cubitel/car-audio/pcb/audio-bom.ods

RefDes |  | Value | Package | Vendor | Part number
C1,C22,C23,C24,C25,C30,C31,C32,C33 | 9 | 1uF 25V X7R | 0805 | Murata | GRM21BR71E105K
C2,C5,C9,C13,C39,C40,C47,C48,C49,C50,C52,C54,C55,C56,C62,C66,C67,C69,C70,C71,C72,C74,C75,C76,C77,C78,C79 | 27 | 0.1uF | 0603
C3,C7,C11 | 3 | 10uF 25V | 1210
C4,C6,C8,C14,C15,C16,C17,C18,C19,C20,C21 | 11 | 1uF 25V X5R | 0603 | Murata | GRM188R61E105K
C10,C12 | 2 | 2.2uF 25V X7R | 0805 | Murata | GRM21BR71E225K
C26,C27,C28,C29,C34,C35,C36,C37 | 8 | 0.01uF | 0603
D1 | 1 | TAS6424Q | SSOP-56 | TI | TAS6424QDKQQ1
D2 | 1 | STM32F407 | TQFP-100 | ST | STM32F407V6T
D3 | 1 | TPS2042BD | SOIC-8
D4 | 1 | TJA1100 | QFN-36 | NXP
D5,D6 | 2 | TJA1041 | SOIC-14 | NXP
D7 | 1 | TLE8366EV50 | SOIC-8 | INFINEON | TLE8366EV50XUMA1
D8 | 1 | LD1117-33 | SOT-223
L1,L2,L3,L4,L5,L6,L7,L8 | 8 | 3.3uH 10A |  | BOURNS | SRP1038A-3R3M
L9,L12,L13,L14 | 4
L10,L11 | 2 | 120nH
L15,L16,L17 | 3 | 100uH |  | EPCOS | B82789C0104N002
L18 | 1 | 4.7uH 10A |  | BOURNS | SRP1038A-4R7M
L19,L20 | 2 | 47uH |  | EPCOS | B82477G4473M
R1,R2,R3,R4 | 4 | 10 | 0603
R5 | 1 | 220 | 0603
R6,R13,R15 | 3 | 1.5k | 0603
R7 | 1 | 5.1k | 0603
R8,R9,R11,R12 | 4 | 4.7k | 0603
R14,R16,R17,R18,R19,R20 | 6 | 10k | 0603
R21,R22,R23,R24 | 4 | 51 | 0603
R25,R26,R28,R29 | 4 | 1k | 0603
R27 | 1 | 100k | 0603
R30,R31 | 2 | 120 | 0603
R32 | 1 | 22k | 0603
VD1,VD2,VD3 | 3 |  |  | ST | ESDCAN03-2BWY
VD4,VD5 | 2 | 15MQ040 | SMA
X1,X2 |  |  |  |  | PBS-8
X3 | 1 | Quadlock |  | TE | 1241768-1
Z1 | 1 | 8 MHz |  | ABRACON | ABM3B-8.000MHZ-B2-T
Z2 | 1 | 25 MHz |  | ABRACON | ABM3B-25.000MHZ-B2-T
