cubitel/car-audio/case/case.SLDPRT

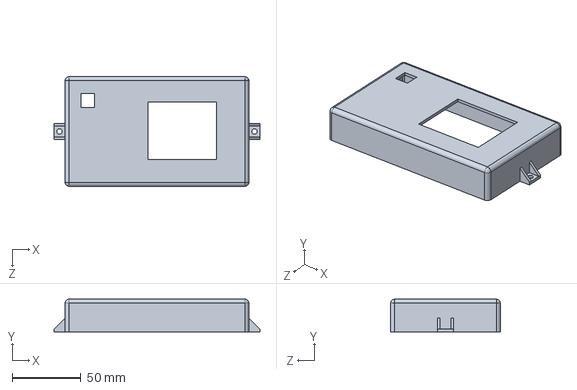
[picture p1: CAD file, 2018-12-22]
case/case.SLDPRT
150.0 x 24.0 x 80.0 mm
