cubitel/car-audio/(list of files, cad)

Other CAD files:
case/case.STL
