cubitel/car-audio/pcb/audio.kicad_pcb

## KiCad design pcb/audio.kicad_pcb (2018-12-22)

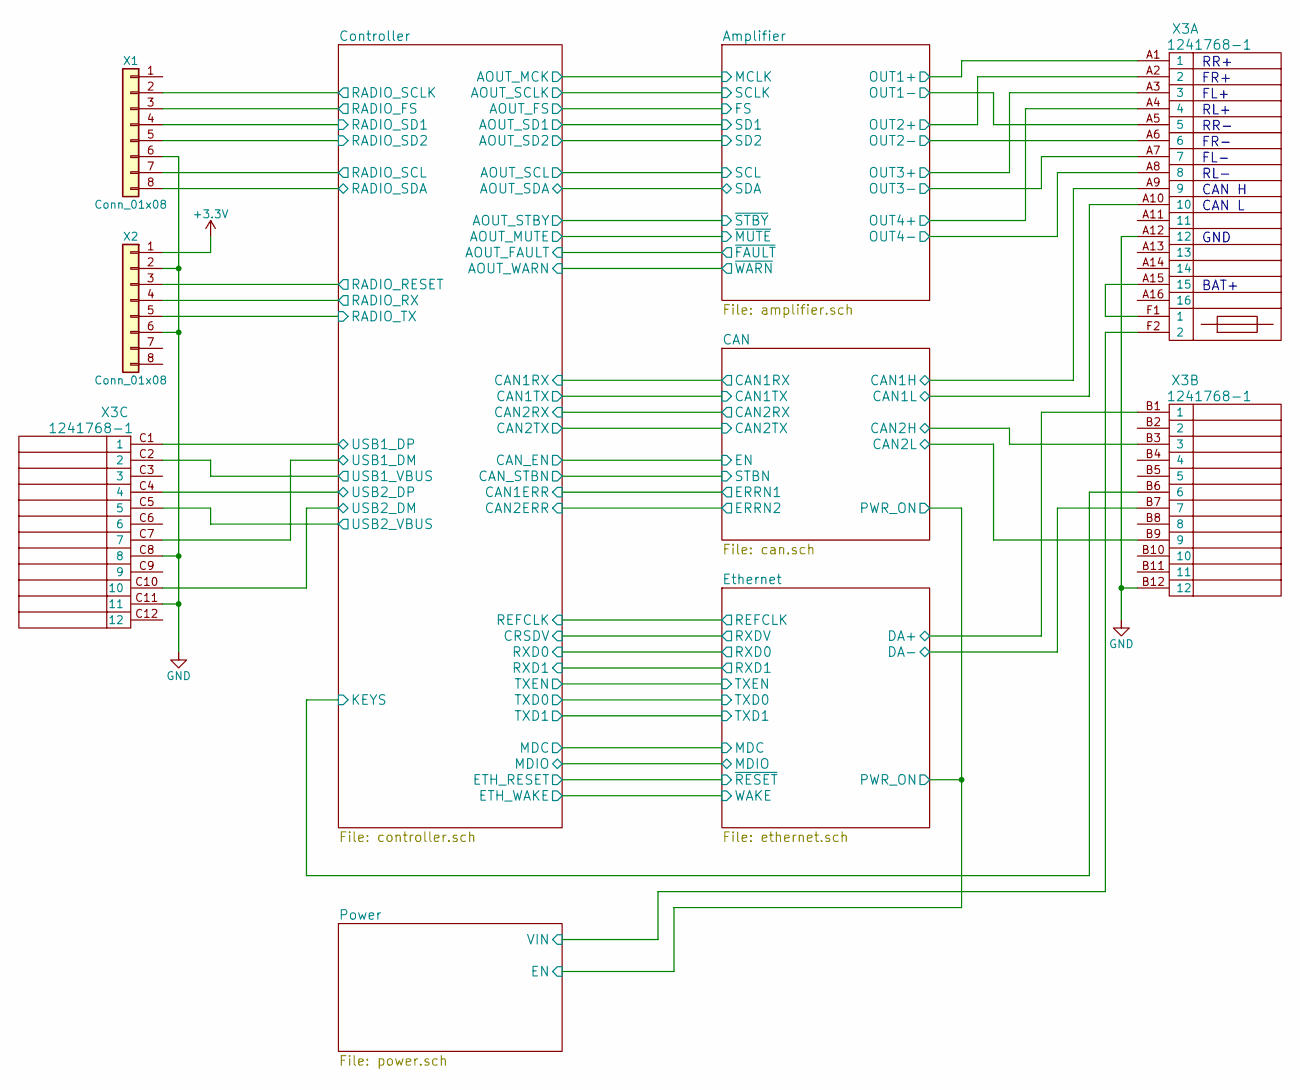
[picture p2: schematic audio.sch]

Parts:
X1, X2: Conn_01x08; Pin_Header_Straight_1x08_Pitch2.54mm
X3: 1241768-1; 1241768

Connections:
+3V3: X2.1; also elsewhere on the board
/Amplifier/OUT1+: X3.A1 (1); also elsewhere on the board
/Amplifier/OUT1-: X3.A5 (5); also elsewhere on the board
/Amplifier/OUT2+: X3.A2 (2); also elsewhere on the board
/Amplifier/OUT2-: X3.A6 (6); also elsewhere on the board
/Amplifier/OUT3+: X3.A3 (3); also elsewhere on the board
/Amplifier/OUT3-: X3.A7 (7); also elsewhere on the board
/Amplifier/OUT4+: X3.A4 (4); also elsewhere on the board
/Amplifier/OUT4-: X3.A8 (8); also elsewhere on the board
/CAN/CAN1H: X3.A9 (9); also elsewhere on the board
/CAN/CAN1L: X3.A10 (10); also elsewhere on the board
/CAN/CAN2H: X3.B3 (3); also elsewhere on the board
/CAN/CAN2L: X3.B9 (9); also elsewhere on the board
/Controller/KEYS: X3.B6 (6); also elsewhere on the board
/Controller/RADIO_FS: X1.3; also elsewhere on the board
/Controller/RADIO_RESET: X2.3; also elsewhere on the board
/Controller/RADIO_RX: X2.4; also elsewhere on the board
/Controller/RADIO_SCL: X1.7; also elsewhere on the board
/Controller/RADIO_SCLK: X1.2; also elsewhere on the board
/Controller/RADIO_SD1: X1.4; also elsewhere on the board
/Controller/RADIO_SD2: X1.5; also elsewhere on the board
/Controller/RADIO_SDA: X1.8; also elsewhere on the board
/Controller/RADIO_TX: X2.5; also elsewhere on the board
/Controller/USB1_DM: X3.C7 (7); also elsewhere on the board
/Controller/USB1_DP: X3.C1 (1); also elsewhere on the board
/Controller/USB1_VBUS: X3.C2 (2); also elsewhere on the board
/Controller/USB2_DM: X3.C10 (10); also elsewhere on the board
/Controller/USB2_DP: X3.C4 (4); also elsewhere on the board
/Controller/USB2_VBUS: X3.C5 (5); also elsewhere on the board
/Ethernet/DA+: X3.B1 (1); also elsewhere on the board
/Ethernet/DA-: X3.B7 (7); also elsewhere on the board
/Power/VIN: X3.F2 (2); also elsewhere on the board
GND: X1.6, X2.2, X2.6, X3.A12 (12), X3.B12 (12), X3.C8 (8), X3.C11 (11); also elsewhere on the board
unnamed: X3.A15 (15), X3.F1 (1)

Notes on the sheet:
RR+
FR+
FL+
RL+
RR-
FR-
FL-
RL-
GND
BAT+
CAN H
CAN L

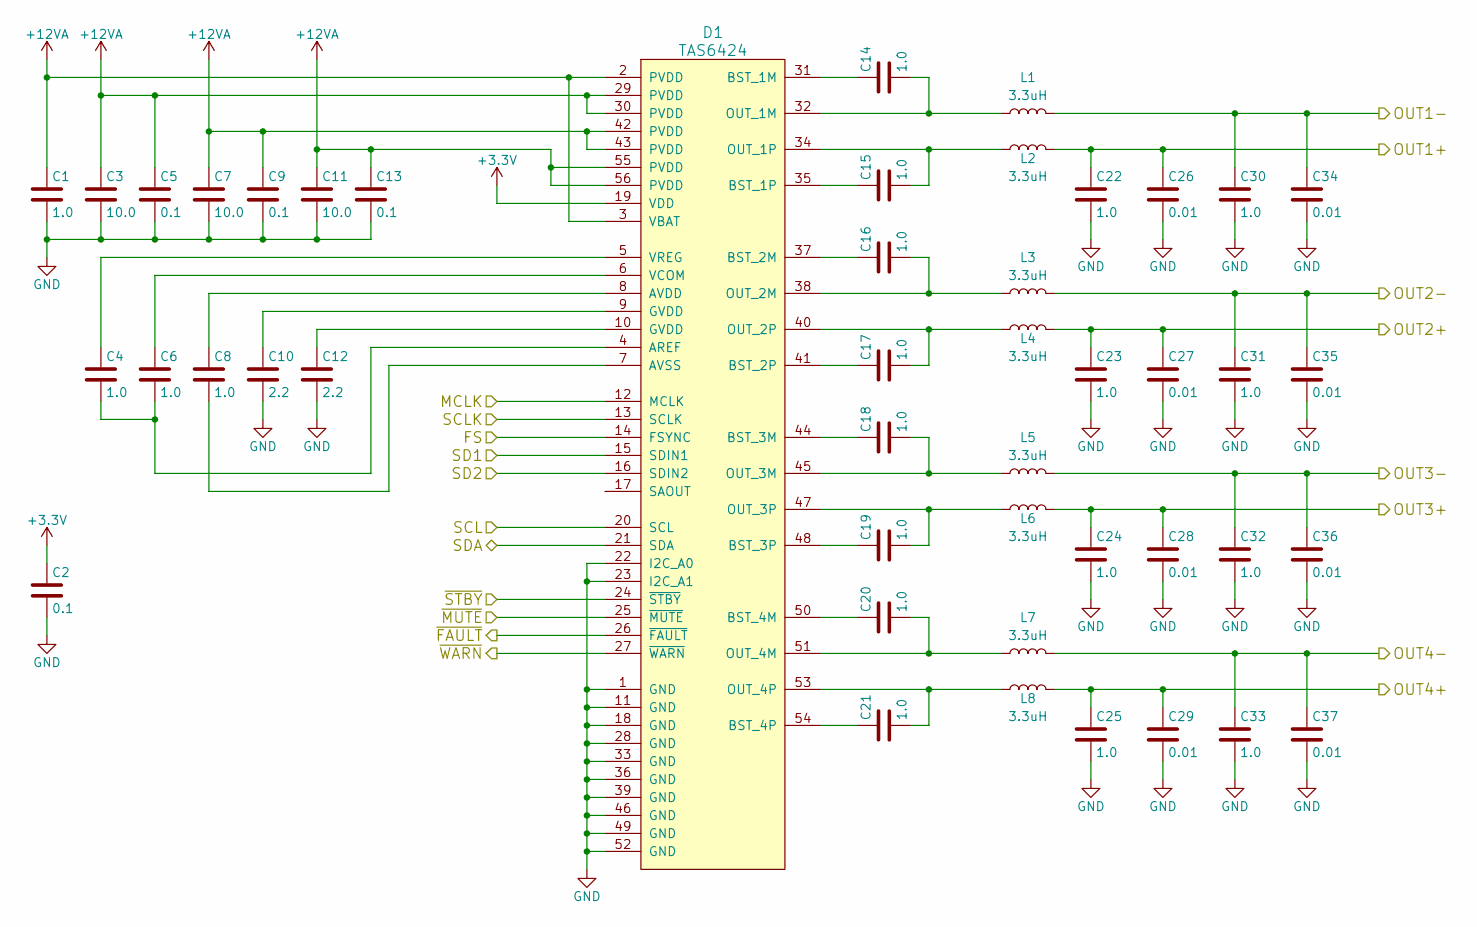
[picture p3: schematic amplifier.sch]

Parts:
C1, C22, C23, C24, C25, C30, C31, C32, C33: 1.0; C_0805
C2, C5, C9, C13: 0.1; C_0603
C3, C7, C11: 10.0; C_1210
C4, C6, C8, C14, C15, C16, C17, C18, C19, C20, C21: 1.0; C_0603
C10, C12: 2.2; C_0805
C26, C27, C28, C29, C34, C35, C36, C37: 0.01; C_0603
D1: TAS6424; SSOP-56_7.5x18.5mm_Pitch0.635mm
L1, L2, L3, L4, L5, L6, L7, L8: 3.3uH; L_10.4x10.4_H4.8

Connections:
+3V3: C2.1, D1.19 (VDD); also elsewhere on the board
+12VA: C1.1, C3.1, C5.1, C7.1, C9.1, C11.1, C13.1, D1.2 (PVDD), D1.3 (VBAT), D1.29 (PVDD), D1.30 (PVDD), D1.42 (PVDD), D1.43 (PVDD), D1.55 (PVDD), D1.56 (PVDD); also elsewhere on the board
/Amplifier/OUT1+: C22.1, C26.1, L2.2; also elsewhere on the board
/Amplifier/OUT1-: C30.1, C34.1, L1.2; also elsewhere on the board
/Amplifier/OUT2+: C23.1, C27.1, L4.2; also elsewhere on the board
/Amplifier/OUT2-: C31.1, C35.1, L3.2; also elsewhere on the board
/Amplifier/OUT3+: C24.1, C28.1, L6.2; also elsewhere on the board
/Amplifier/OUT3-: C32.1, C36.1, L5.2; also elsewhere on the board
/Amplifier/OUT4+: C25.1, C29.1, L8.2; also elsewhere on the board
/Amplifier/OUT4-: C33.1, C37.1, L7.2; also elsewhere on the board
/Controller/AOUT_FAULT: D1.26 (~FAULT); also elsewhere on the board
/Controller/AOUT_FS: D1.14 (FSYNC); also elsewhere on the board
/Controller/AOUT_MCK: D1.12 (MCLK); also elsewhere on the board
/Controller/AOUT_MUTE: D1.25 (~MUTE); also elsewhere on the board
/Controller/AOUT_SCL: D1.20 (SCL); also elsewhere on the board
/Controller/AOUT_SCLK: D1.13 (SCLK); also elsewhere on the board
/Controller/AOUT_SD1: D1.15 (SDIN1); also elsewhere on the board
/Controller/AOUT_SD2: D1.16 (SDIN2); also elsewhere on the board
/Controller/AOUT_SDA: D1.21 (SDA); also elsewhere on the board
/Controller/AOUT_STBY: D1.24 (~STBY); also elsewhere on the board
/Controller/AOUT_WARN: D1.27 (~WARN); also elsewhere on the board
GND: C1.2, C2.2, C3.2, C5.2, C7.2, C9.2, C10.2, C11.2, C12.2, C13.2, C22.2, C23.2, C24.2, C25.2, C26.2, C27.2, C28.2, C29.2, C30.2, C31.2, C32.2, C33.2, C34.2, C35.2, C36.2, C37.2, D1.1 (GND), D1.11 (GND), D1.18 (GND), D1.22 (I2C_A0), D1.23 (I2C_A1), D1.28 (GND), D1.33 (GND), D1.36 (GND), D1.39 (GND), D1.46 (GND), D1.49 (GND), D1.52 (GND); also elsewhere on the board
unnamed: C4.1, D1.5 (VREG)
unnamed: C4.2, C6.2, D1.4 (AREF)
unnamed: C6.1, D1.6 (VCOM)
unnamed: C8.1, D1.8 (AVDD)
unnamed: C8.2, D1.7 (AVSS)
unnamed: C10.1, D1.9 (GVDD)
unnamed: C12.1, D1.10 (GVDD)
unnamed: C14.1, D1.31 (BST_1M)
unnamed: C14.2, D1.32 (OUT_1M), L1.1
unnamed: C15.1, D1.35 (BST_1P)
unnamed: C15.2, D1.34 (OUT_1P), L2.1
unnamed: C16.1, D1.37 (BST_2M)
unnamed: C16.2, D1.38 (OUT_2M), L3.1
unnamed: C17.1, D1.41 (BST_2P)
unnamed: C17.2, D1.40 (OUT_2P), L4.1
unnamed: C18.1, D1.44 (BST_3M)
unnamed: C18.2, D1.45 (OUT_3M), L5.1
unnamed: C19.1, D1.48 (BST_3P)
unnamed: C19.2, D1.47 (OUT_3P), L6.1
unnamed: C20.1, D1.50 (BST_4M)
unnamed: C20.2, D1.51 (OUT_4M), L7.1
unnamed: C21.1, D1.54 (BST_4P)
unnamed: C21.2, D1.53 (OUT_4P), L8.1

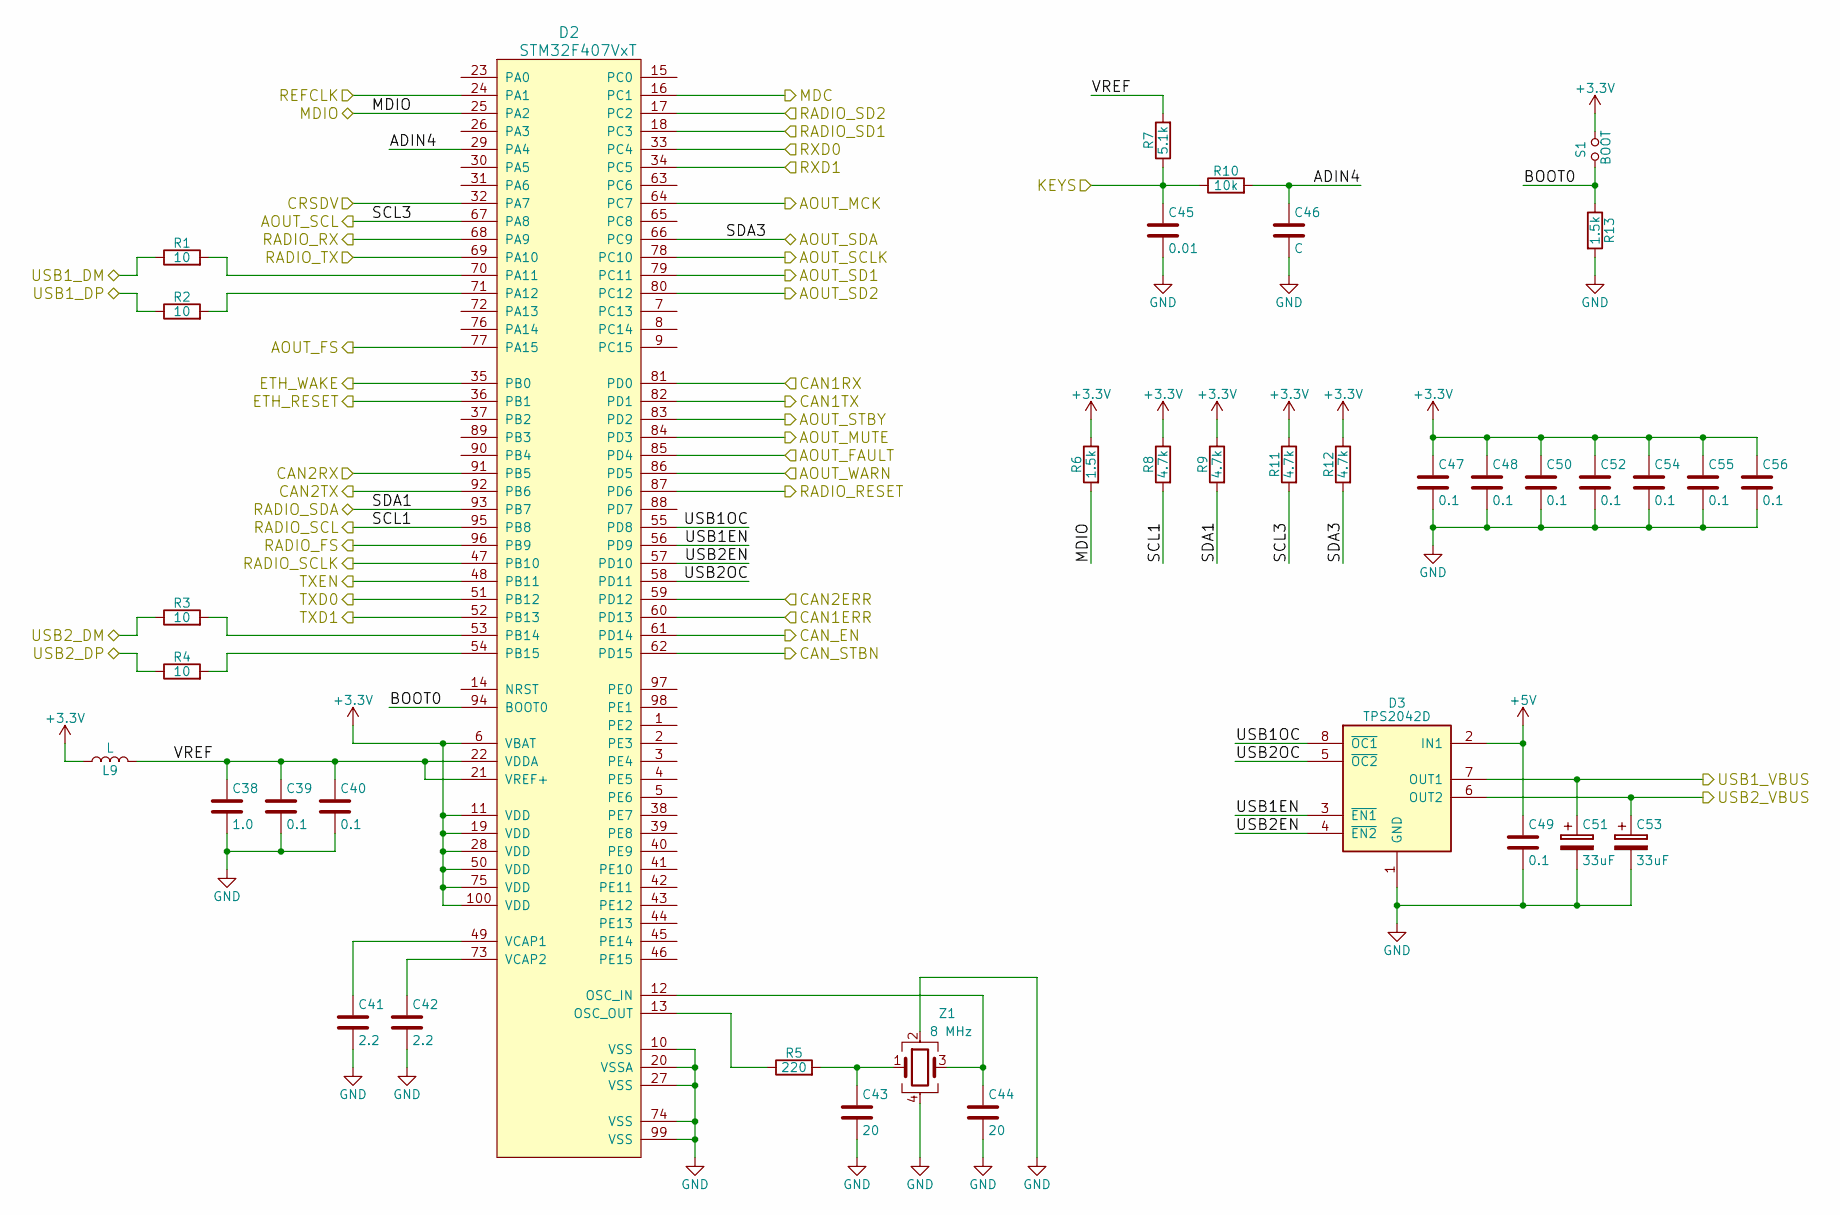
[picture p4: schematic controller.sch]

Parts:
C38: 1.0; C_0603
C39, C40, C47, C48, C49, C50, C52, C54, C55, C56: 0.1; C_0603
C41, C42: 2.2; C_0603
C43, C44: 20; C_0603
C45: 0.01; C_0603
C46: C; C_0603
C51, C53: 33uF; CP_Tantalum_Case-B_EIA-3528-21_Reflow
D2: STM32F407VxT; LQFP-100_14x14mm_Pitch0.5mm
D3: TPS2042D; SOIC-8_3.9x4.9mm_Pitch1.27mm
L9: L; L_0805
R1, R2, R3, R4: 10; R_0603
R5: 220; R_0603
R6, R13: 1.5k; R_0603
R7: 5.1k; R_0603
R8, R9, R11, R12: 4.7k; R_0603
R10: 10k; R_0603
S1: BOOT; Pin_Header_Straight_1x02_Pitch1.27mm
Z1: 8 MHz; Crystal_5x3

Connections:
+3V3: C47.1, C48.1, C50.1, C52.1, C54.1, C55.1, C56.1, D2.6 (VBAT), D2.11 (VDD), D2.19 (VDD), D2.28 (VDD), D2.50 (VDD), D2.75 (VDD), D2.100 (VDD), L9.1, R6.1, R8.1, R9.1, R11.1, R12.1, S1.2; also elsewhere on the board
+5V: C49.1, D3.2 (IN1); also elsewhere on the board
/CAN/CAN1RX: D2.81 (PD0); also elsewhere on the board
/CAN/CAN1TX: D2.82 (PD1); also elsewhere on the board
/CAN/CAN2RX: D2.91 (PB5); also elsewhere on the board
/CAN/CAN2TX: D2.92 (PB6); also elsewhere on the board
/Controller/ADIN4: C46.1, D2.29 (PA4), R10.2
/Controller/AOUT_FAULT: D2.85 (PD4); also elsewhere on the board
/Controller/AOUT_FS: D2.77 (PA15); also elsewhere on the board
/Controller/AOUT_MCK: D2.64 (PC7); also elsewhere on the board
/Controller/AOUT_MUTE: D2.84 (PD3); also elsewhere on the board
/Controller/AOUT_SCL: D2.67 (PA8), R11.2; also elsewhere on the board
/Controller/AOUT_SCLK: D2.78 (PC10); also elsewhere on the board
/Controller/AOUT_SD1: D2.79 (PC11); also elsewhere on the board
/Controller/AOUT_SD2: D2.80 (PC12); also elsewhere on the board
/Controller/AOUT_SDA: D2.66 (PC9), R12.2; also elsewhere on the board
/Controller/AOUT_STBY: D2.83 (PD2); also elsewhere on the board
/Controller/AOUT_WARN: D2.86 (PD5); also elsewhere on the board
/Controller/BOOT0: D2.94 (BOOT0), R13.1, S1.1
/Controller/CAN1ERR: D2.60 (PD13); also elsewhere on the board
/Controller/CAN2ERR: D2.59 (PD12); also elsewhere on the board
/Controller/CAN_EN: D2.61 (PD14); also elsewhere on the board
/Controller/CAN_STBN: D2.62 (PD15); also elsewhere on the board
/Controller/CRSDV: D2.32 (PA7); also elsewhere on the board
/Controller/ETH_RESET: D2.36 (PB1); also elsewhere on the board
/Controller/ETH_WAKE: D2.35 (PB0); also elsewhere on the board
/Controller/KEYS: C45.1, R7.1, R10.1; also elsewhere on the board
/Controller/MDC: D2.16 (PC1); also elsewhere on the board
/Controller/MDIO: D2.25 (PA2), R6.2; also elsewhere on the board
/Controller/RADIO_FS: D2.96 (PB9); also elsewhere on the board
/Controller/RADIO_RESET: D2.87 (PD6); also elsewhere on the board
/Controller/RADIO_RX: D2.68 (PA9); also elsewhere on the board
/Controller/RADIO_SCL: D2.95 (PB8), R8.2; also elsewhere on the board
/Controller/RADIO_SCLK: D2.47 (PB10); also elsewhere on the board
/Controller/RADIO_SD1: D2.18 (PC3); also elsewhere on the board
/Controller/RADIO_SD2: D2.17 (PC2); also elsewhere on the board
/Controller/RADIO_SDA: D2.93 (PB7), R9.2; also elsewhere on the board
/Controller/RADIO_TX: D2.69 (PA10); also elsewhere on the board
/Controller/REFCLK: D2.24 (PA1); also elsewhere on the board
/Controller/RXD0: D2.33 (PC4); also elsewhere on the board
/Controller/RXD1: D2.34 (PC5); also elsewhere on the board
/Controller/TXD0: D2.51 (PB12); also elsewhere on the board
/Controller/TXD1: D2.52 (PB13); also elsewhere on the board
/Controller/TXEN: D2.48 (PB11); also elsewhere on the board
/Controller/USB1EN: D2.56 (PD9), D3.3 (~EN1)
/Controller/USB1OC: D2.55 (PD8), D3.8 (~OC1)
/Controller/USB1_DM: R1.1; also elsewhere on the board
/Controller/USB1_DP: R2.1; also elsewhere on the board
/Controller/USB1_VBUS: C51.1, D3.7 (OUT1); also elsewhere on the board
/Controller/USB2EN: D2.57 (PD10), D3.4 (~EN2)
/Controller/USB2OC: D2.58 (PD11), D3.5 (~OC2)
/Controller/USB2_DM: R3.1; also elsewhere on the board
/Controller/USB2_DP: R4.1; also elsewhere on the board
/Controller/USB2_VBUS: C53.1, D3.6 (OUT2); also elsewhere on the board
/Controller/VREF: C38.1, C39.1, C40.1, D2.21 (VREF+), D2.22 (VDDA), L9.2, R7.2
GND: C38.2, C39.2, C40.2, C41.2, C42.2, C43.2, C44.2, C45.2, C46.2, C47.2, C48.2, C49.2, C50.2, C51.2, C52.2, C53.2, C54.2, C55.2, C56.2, D2.10 (VSS), D2.20 (VSSA), D2.27 (VSS), D2.74 (VSS), D2.99 (VSS), D3.1 (GND), R13.2, Z1.2, Z1.4; also elsewhere on the board
unnamed: C41.1, D2.49 (VCAP1)
unnamed: C42.1, D2.73 (VCAP2)
unnamed: C43.1, R5.2, Z1.1
unnamed: C44.1, D2.12 (OSC_IN), Z1.3
unnamed: D2.13 (OSC_OUT), R5.1
unnamed: D2.53 (PB14), R3.2
unnamed: D2.54 (PB15), R4.2
unnamed: D2.70 (PA11), R1.2
unnamed: D2.71 (PA12), R2.2

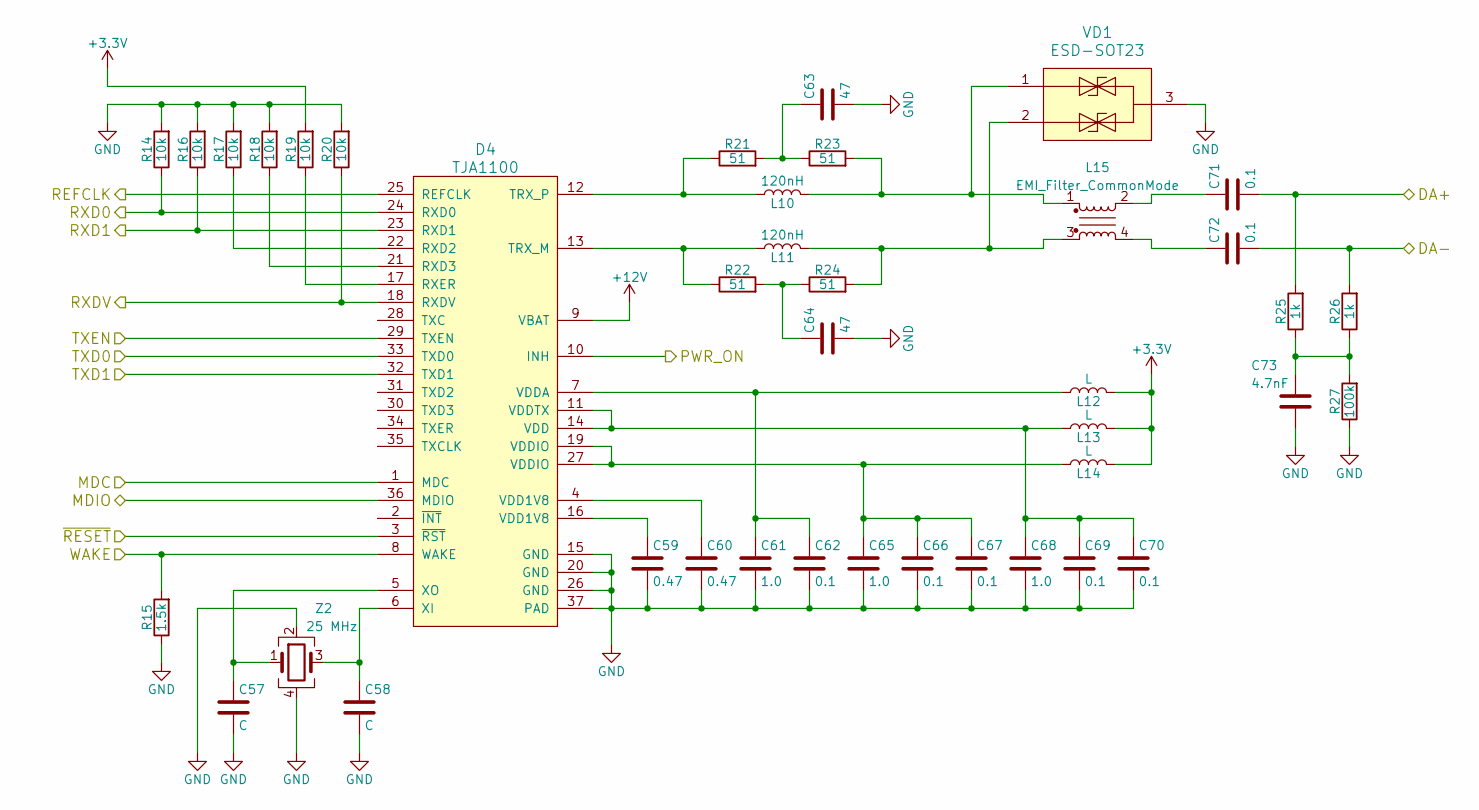
[picture p5: schematic ethernet.sch]

Parts:
C57, C58: C; C_0603
C59, C60: 0.47; C_0603
C61, C65, C68: 1.0; C_0603
C62, C66, C67, C69, C70, C71, C72: 0.1; C_0603
C63, C64: 47; C_0603
C73: 4.7nF; C_0603
D4: TJA1100; QFN-36-1EP_6x6mm_Pitch0.5mm
L10, L11: 120nH; L_0805
L12, L13, L14: L; L_0805
L15: EMI_Filter_CommonMode; SIMDAD 1812
R14, R16, R17, R18, R19, R20: 10k; R_0603
R15: 1.5k; R_0603
R21, R22, R23, R24: 51; R_0603
R25, R26: 1k; R_0603
R27: 100k; R_0603
VD1: ESD-SOT23; SOT-23
Z2: 25 MHz; Crystal_5x3

Connections:
+3V3: L12.2, L13.2, L14.2, R19.2; also elsewhere on the board
+12V: D4.9 (VBAT); also elsewhere on the board
/Controller/CRSDV: D4.18 (RXDV), R20.1; also elsewhere on the board
/Controller/ETH_RESET: D4.3 (~RST); also elsewhere on the board
/Controller/ETH_WAKE: D4.8 (WAKE), R15.2; also elsewhere on the board
/Controller/MDC: D4.1 (MDC); also elsewhere on the board
/Controller/MDIO: D4.36 (MDIO); also elsewhere on the board
/Controller/REFCLK: D4.25 (REFCLK); also elsewhere on the board
/Controller/RXD0: D4.24 (RXD0), R14.1; also elsewhere on the board
/Controller/RXD1: D4.23 (RXD1), R16.1; also elsewhere on the board
/Controller/TXD0: D4.33 (TXD0); also elsewhere on the board
/Controller/TXD1: D4.32 (TXD1); also elsewhere on the board
/Controller/TXEN: D4.29 (TXEN); also elsewhere on the board
/Ethernet/DA+: C71.2, R25.2; also elsewhere on the board
/Ethernet/DA-: C72.2, R26.2; also elsewhere on the board
/Power/EN: D4.10 (INH); also elsewhere on the board
GND: C57.2, C58.2, C59.2, C60.2, C61.2, C62.2, C63.2, C64.2, C65.2, C66.2, C67.2, C68.2, C69.2, C70.2, C73.2, D4.15 (GND), D4.20 (GND), D4.26 (GND), D4.37 (PAD), R14.2, R15.1, R16.2, R17.2, R18.2, R20.2, R27.1, VD1.3, Z2.2, Z2.4; also elsewhere on the board
unnamed: C57.1, D4.5 (XO), Z2.1
unnamed: C58.1, D4.6 (XI), Z2.3
unnamed: C59.1, D4.16 (VDD1V8)
unnamed: C60.1, D4.4 (VDD1V8)
unnamed: C61.1, C62.1, D4.7 (VDDA), L12.1
unnamed: C63.1, R21.2, R23.1
unnamed: C64.1, R22.2, R24.1
unnamed: C65.1, C66.1, C67.1, D4.19 (VDDIO), D4.27 (VDDIO), L14.1
unnamed: C68.1, C69.1, C70.1, D4.11 (VDDTX), D4.14 (VDD), L13.1
unnamed: C71.1, L15.2
unnamed: C72.1, L15.4
unnamed: C73.1, R25.1, R26.1, R27.2
unnamed: D4.12 (TRX_P), L10.1, R21.1
unnamed: D4.13 (TRX_M), L11.1, R22.1
unnamed: D4.17 (RXER), R19.1
unnamed: D4.21 (RXD3), R18.1
unnamed: D4.22 (RXD2), R17.1
unnamed: L10.2, L15.1, R23.2, VD1.1
unnamed: L11.2, L15.3, R24.2, VD1.2

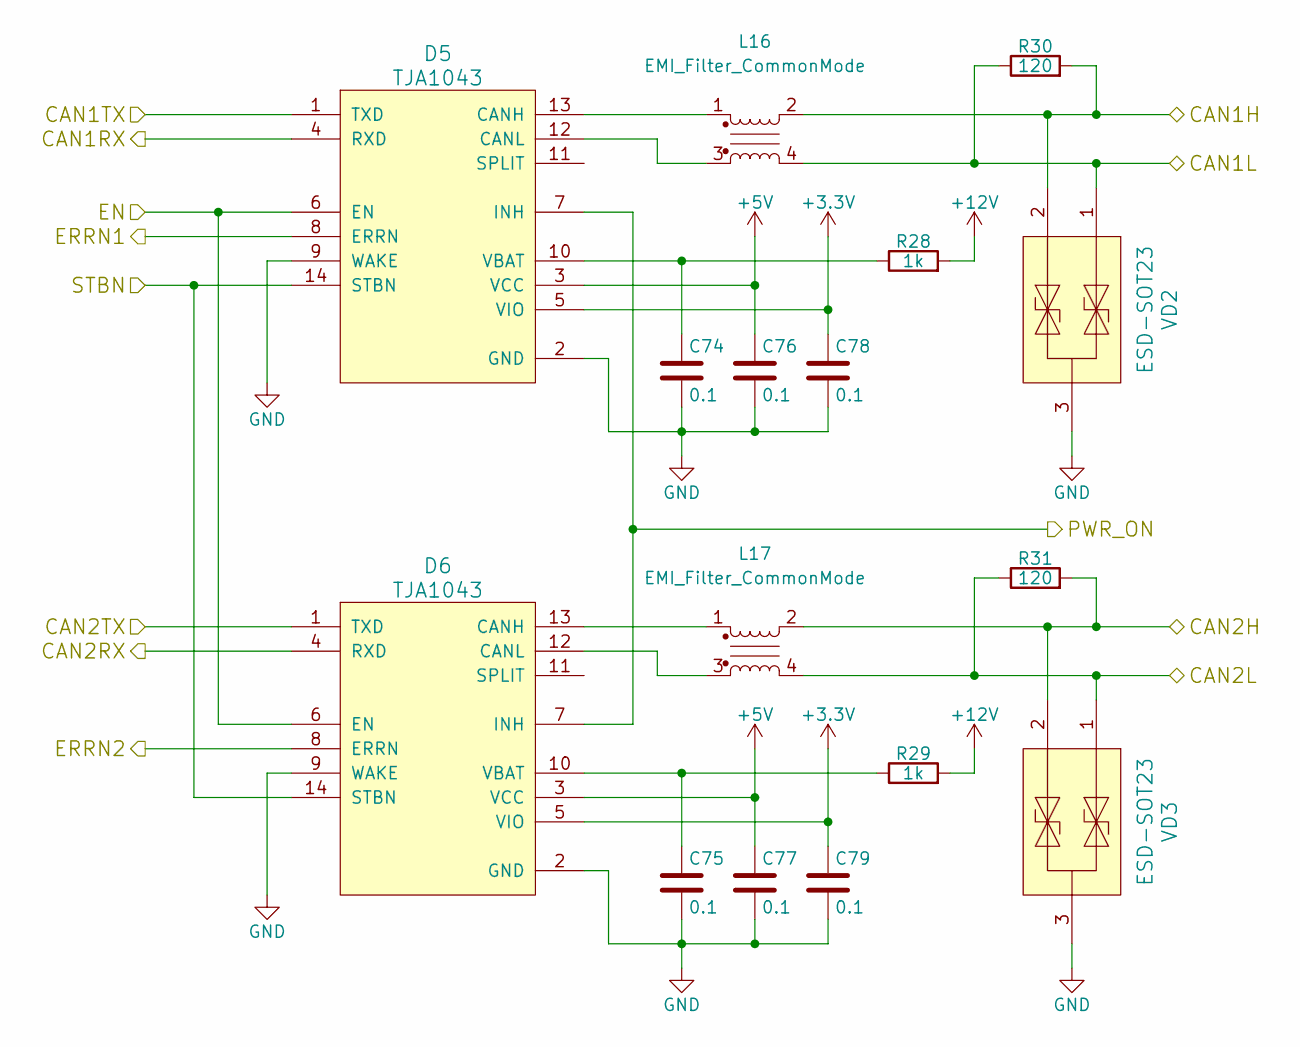
[picture p6: schematic can.sch]

Parts:
C74, C75, C76, C77, C78, C79: 0.1; C_0603
D5, D6: TJA1043; SOIC-14_3.9x8.7mm_Pitch1.27mm
L16, L17: EMI_Filter_CommonMode; SIMDAD 1812
R28, R29: 1k; R_0603
R30, R31: 120; R_0603
VD2, VD3: ESD-SOT23; SOT-23

Connections:
+3V3: C78.1, C79.1, D5.5 (VIO), D6.5 (VIO); also elsewhere on the board
+5V: C76.1, C77.1, D5.3 (VCC), D6.3 (VCC); also elsewhere on the board
+12V: R28.2, R29.2; also elsewhere on the board
/CAN/CAN1H: L16.2, R30.2, VD2.2; also elsewhere on the board
/CAN/CAN1L: L16.4, R30.1, VD2.1; also elsewhere on the board
/CAN/CAN1RX: D5.4 (RXD); also elsewhere on the board
/CAN/CAN1TX: D5.1 (TXD); also elsewhere on the board
/CAN/CAN2H: L17.2, R31.2, VD3.2; also elsewhere on the board
/CAN/CAN2L: L17.4, R31.1, VD3.1; also elsewhere on the board
/CAN/CAN2RX: D6.4 (RXD); also elsewhere on the board
/CAN/CAN2TX: D6.1 (TXD); also elsewhere on the board
/Controller/CAN1ERR: D5.8 (ERRN); also elsewhere on the board
/Controller/CAN2ERR: D6.8 (ERRN); also elsewhere on the board
/Controller/CAN_EN: D5.6 (EN), D6.6 (EN); also elsewhere on the board
/Controller/CAN_STBN: D5.14 (STBN), D6.14 (STBN); also elsewhere on the board
/Power/EN: D5.7 (INH), D6.7 (INH); also elsewhere on the board
GND: C74.2, C75.2, C76.2, C77.2, C78.2, C79.2, D5.2 (GND), D5.9 (WAKE), D6.2 (GND), D6.9 (WAKE), VD2.3, VD3.3; also elsewhere on the board
unnamed: C74.1, D5.10 (VBAT), R28.1
unnamed: C75.1, D6.10 (VBAT), R29.1
unnamed: D5.12 (CANL), L16.3
unnamed: D5.13 (CANH), L16.1
unnamed: D6.12 (CANL), L17.3
unnamed: D6.13 (CANH), L17.1

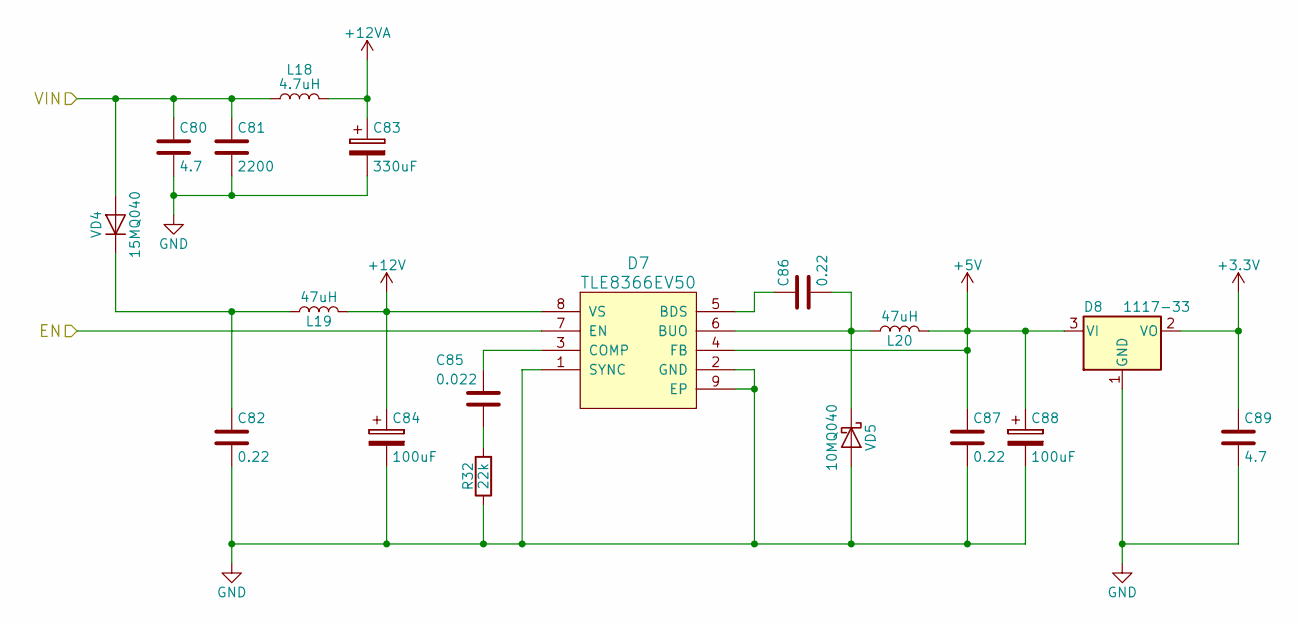
[picture p7: schematic power.sch]

Parts:
C80: 4.7; C_1206
C81: 2200; C_0603
C82: 0.22; C_0805
C83: 330uF; CP_Elec_10x10.5
C84: 100uF; CP_Elec_10x10.5
C85: 0.022; C_0603
C86, C87: 0.22; C_0603
C88: 100uF; CP_Tantalum_Case-D_EIA-7343-31_Reflow
C89: 4.7; C_0603
D7: TLE8366EV50; SOIC-8-1EP_3.9x4.9mm_Pitch1.27mm
D8: 1117-33; SOT-223-3_TabPin2
L18: 4.7uH; L_10.4x10.4_H4.8
L19, L20: 47uH; L_12x12mm_h8mm
R32: 22k; R_0603
VD4: 15MQ040; D_SMA
VD5: 10MQ040; D_SMA

Connections:
+3V3: C89.1, D8.2 (VO); also elsewhere on the board
+5V: C87.1, C88.1, D7.4 (FB), D8.3 (VI), L20.2; also elsewhere on the board
+12V: C84.1, D7.8 (VS), L19.2; also elsewhere on the board
+12VA: C83.1, L18.2; also elsewhere on the board
/Power/EN: D7.7 (EN); also elsewhere on the board
/Power/VIN: C80.1, C81.1, L18.1, VD4.2 (A); also elsewhere on the board
GND: C80.2, C81.2, C82.2, C83.2, C84.2, C87.2, C88.2, C89.2, D7.1 (SYNC), D7.2 (GND), D7.9 (EP), D8.1 (GND), R32.1, VD5.2 (A); also elsewhere on the board
unnamed: C82.1, L19.1, VD4.1 (K)
unnamed: C85.1, D7.3 (COMP)
unnamed: C85.2, R32.2
unnamed: C86.1, D7.5 (BDS)
unnamed: C86.2, D7.6 (BUO), L20.1, VD5.1 (K)

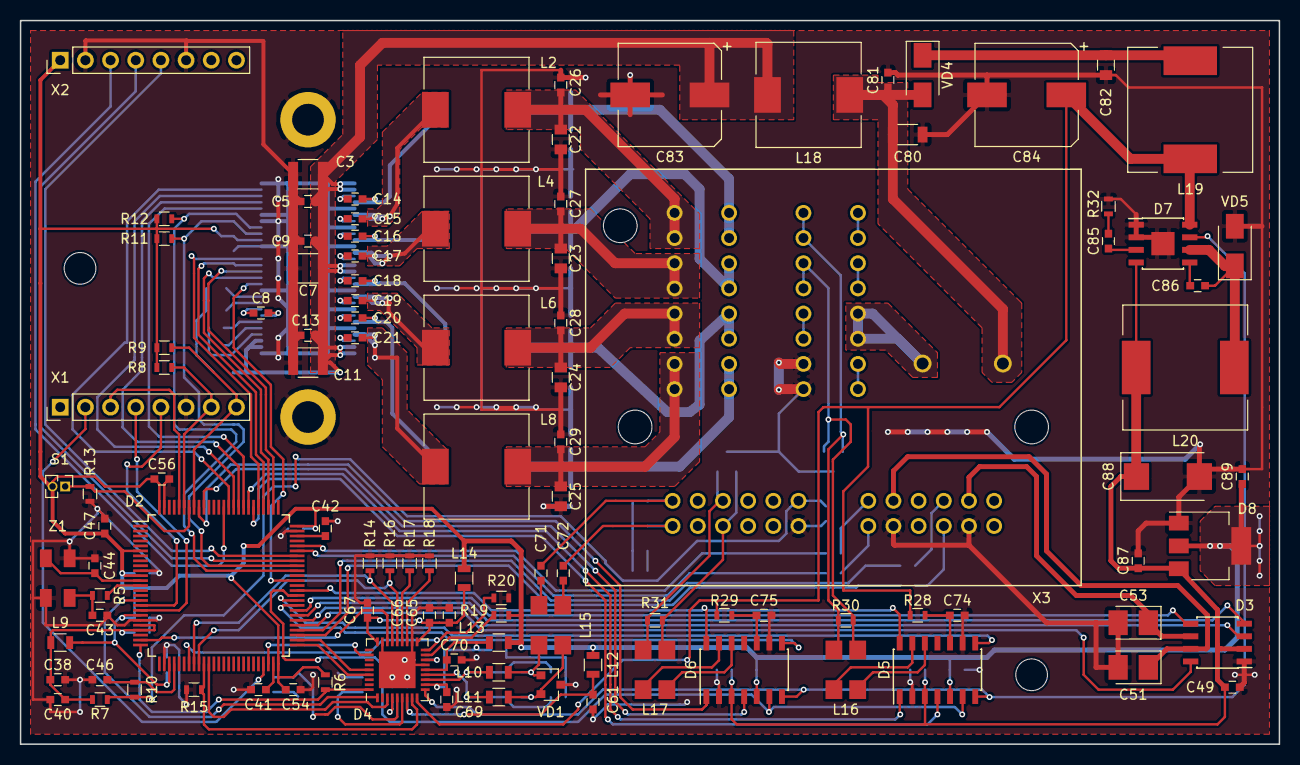
[picture p8: board audio.kicad_pcb from above]

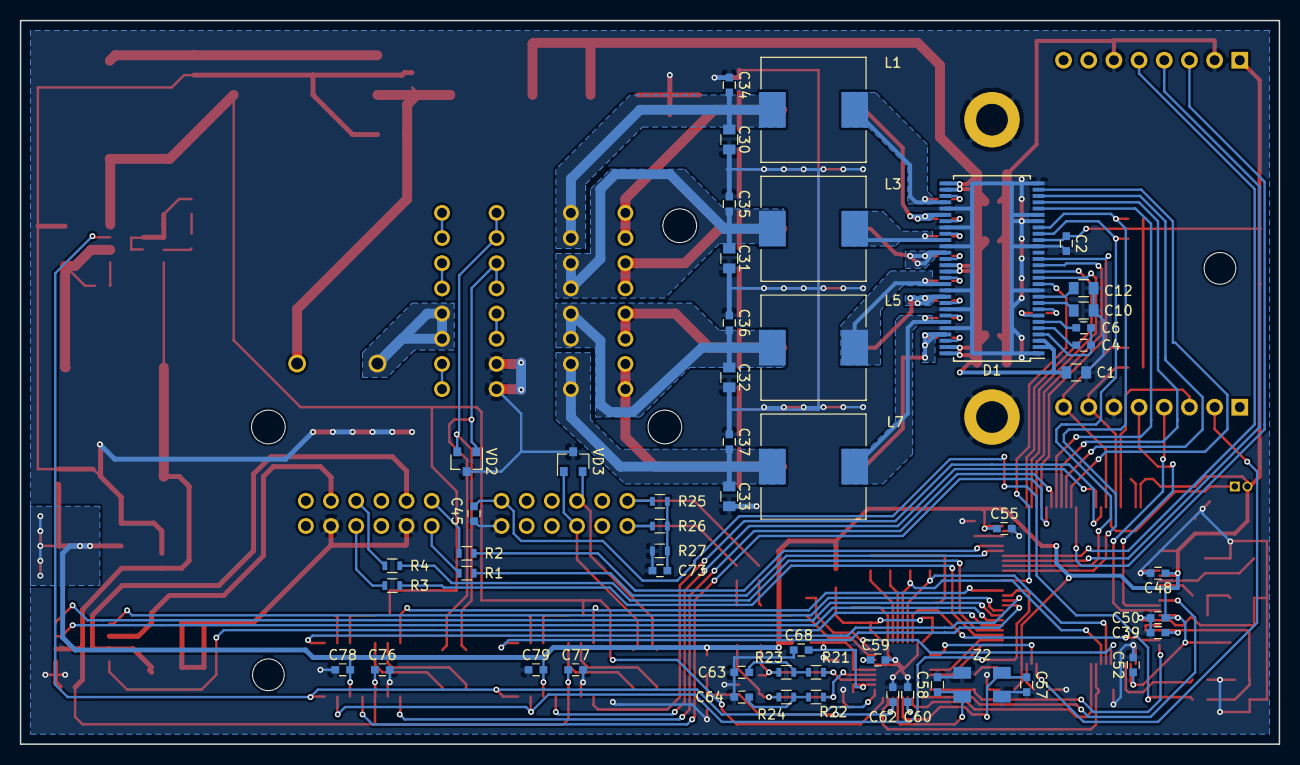
[picture p9: board audio.kicad_pcb from below]

Board: 2 copper layers, 127.0 x 73.0 mm, 160 parts (52 on the bottom side), 137 nets.
