cubitel/car-audio/pcb/radio-si47xx.kicad_pcb

## KiCad design pcb/radio-si47xx.kicad_pcb (2018-12-22)

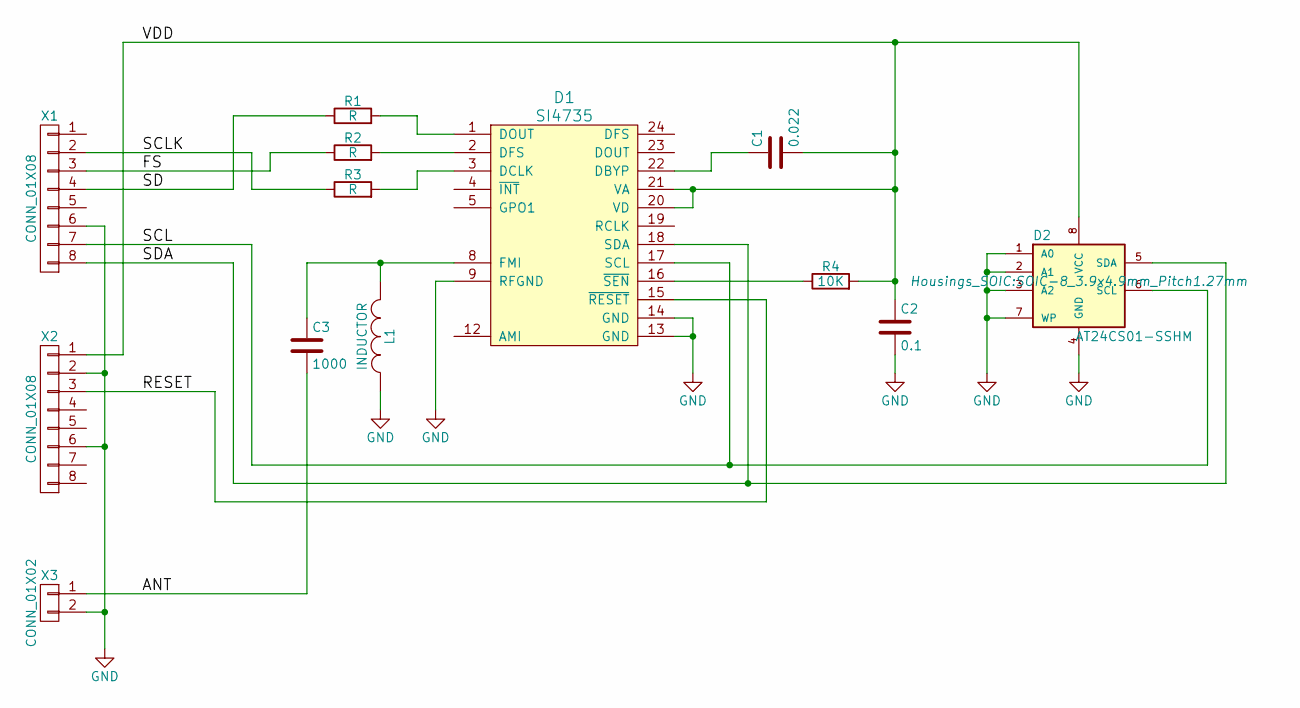
[picture p10: schematic radio-si47xx.sch]

Parts:
C1: 0.022; C_0603
C2: 0.1; C_0603
C3: 1000; C_0603
D1: SI4735; SSOP-24_3.9x8.7mm_Pitch0.635mm
D2: AT24CS01-SSHM; SOIC-8_3.9x4.9mm_Pitch1.27mm
L1: INDUCTOR; R_0603
R1, R2, R3: R; R_0603
R4: 10K; R_0603
X1, X2: CONN_01X08; Socket_Strip_Straight_1x08
X3: CONN_01X02; F_CONNECTOR

Connections:
/ANT: C3.2, X3.1
/FS: R2.1, X1.3
/RESET: D1.15 (~RESET), X2.3
/SCL: D1.17 (SCL), D2.6 (SCL), X1.7
/SCLK: R3.1, X1.2
/SD: R1.1, X1.4
/SDA: D1.18 (SDA), D2.5 (SDA), X1.8
/VDD: C1.2, C2.1, D1.20 (VD), D1.21 (VA), D2.8 (VCC), R4.2, X2.1
GND: C2.2, D1.9 (RFGND), D1.13 (GND), D1.14 (GND), D2.1 (A0), D2.2 (A1), D2.3 (A2), D2.4 (GND), D2.7 (WP), L1.1, X1.6, X2.2, X2.6, X3.2
unnamed: C1.1, D1.22 (DBYP)
unnamed: C3.1, D1.8 (FMI), L1.2
unnamed: D1.1 (DOUT), R1.2
unnamed: D1.2 (DFS), R2.2
unnamed: D1.3 (DCLK), R3.2
unnamed: D1.16 (~SEN), R4.1

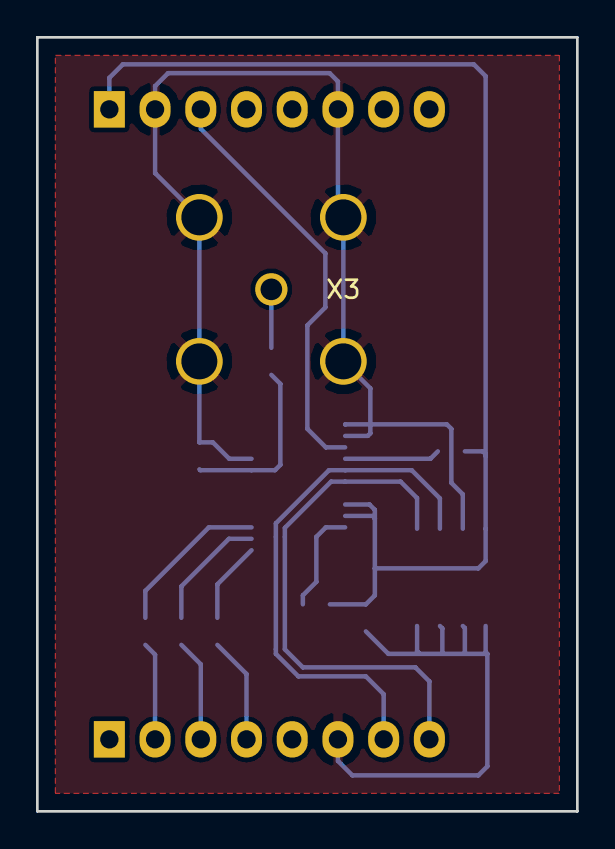
[picture p11: board radio-si47xx.kicad_pcb from above]

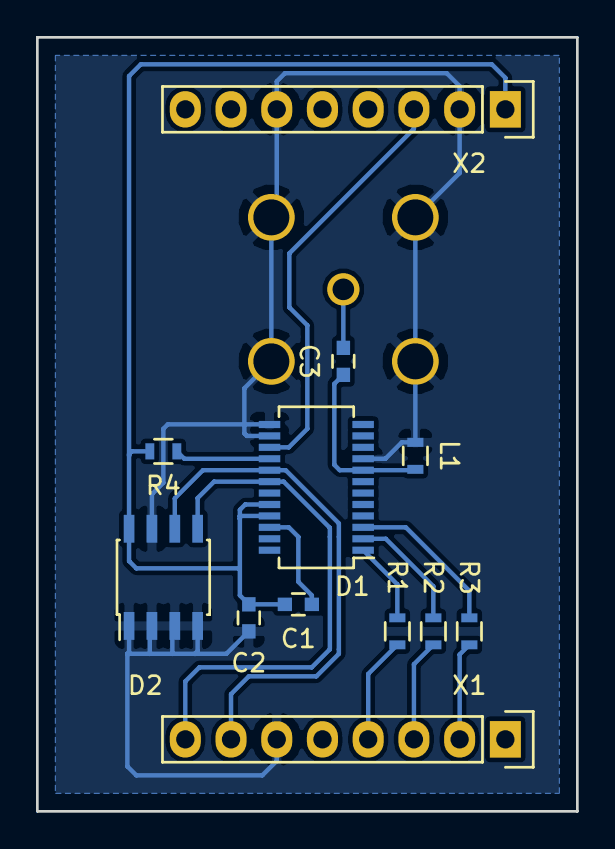
[picture p12: board radio-si47xx.kicad_pcb from below]

Board: 2 copper layers, 30.0 x 43.0 mm, 13 parts (12 on the bottom side), 15 nets.
